CosmicThinker121/ESP32-S3-Smart-Home-Automation-System-/fig4.1-firmware-upload-arduino-ide.png

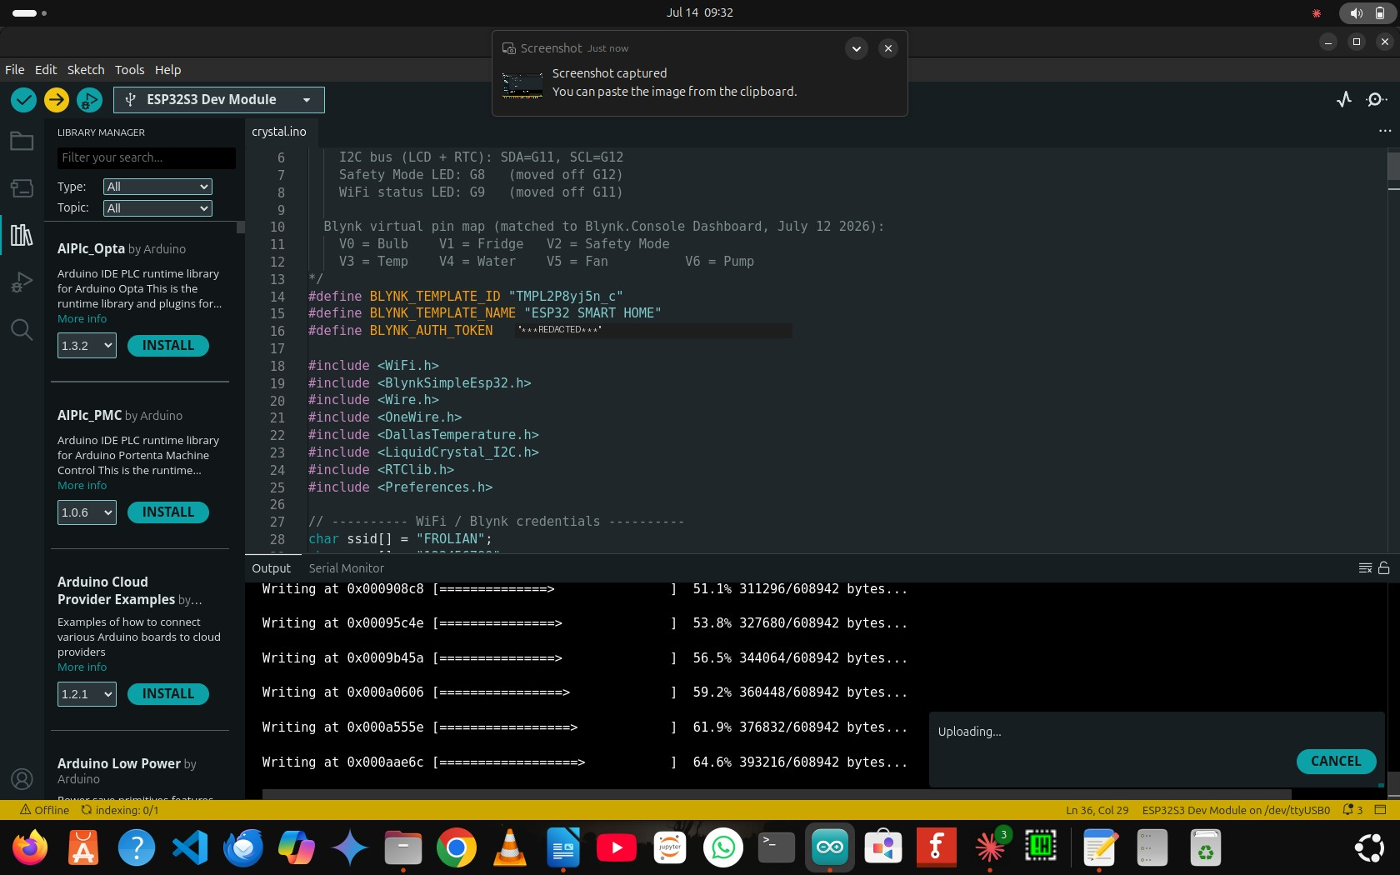
fig4.1-firmware-upload-arduino-ide.png
